semyon422/vsrgkb/README.md

# vsrgkb
 Split mechanical keyboard for rhythm games

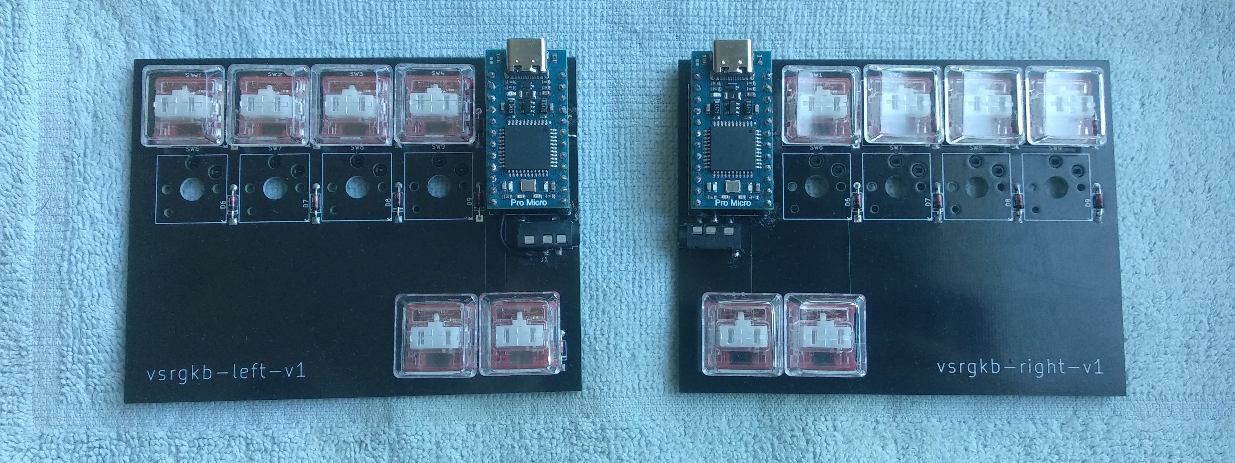
[picture p1: top.jpg]
top view

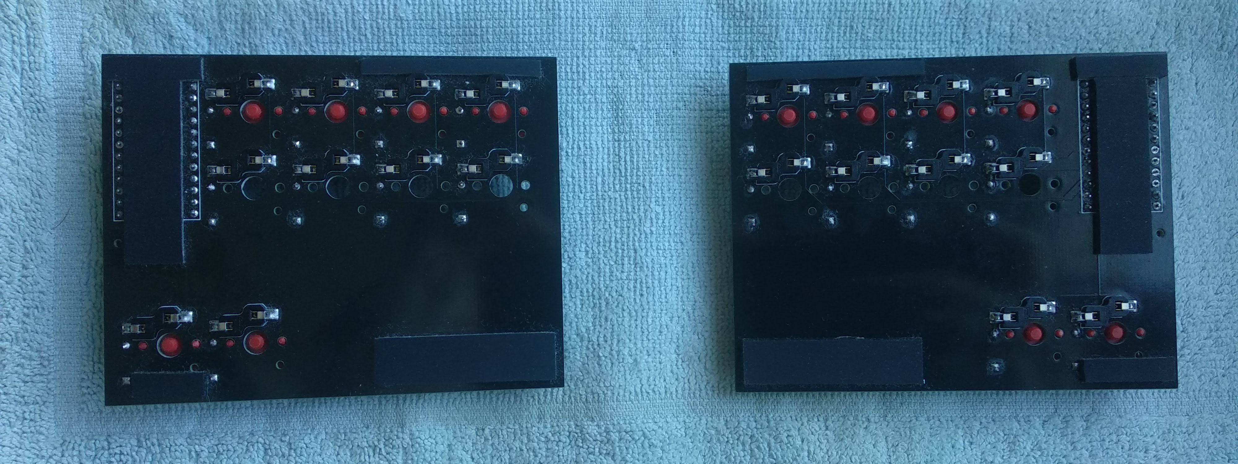
[picture p2: bottom.jpg]
bottom view
