semyon422/vsrgkb/kicad/readme.md

# hardware issues

## v1

Wrong pin choosen for communication. D1 is recommended.  
Pull-up and pull-down resistors are missing for handedness detection.
