semyon422/vsrgkb/kicad/vsrgkb-v1-left/vsrgkb-left.kicad_pcb

## KiCad design kicad/vsrgkb-v1-left/vsrgkb-left.kicad_pcb (2023-01-23)

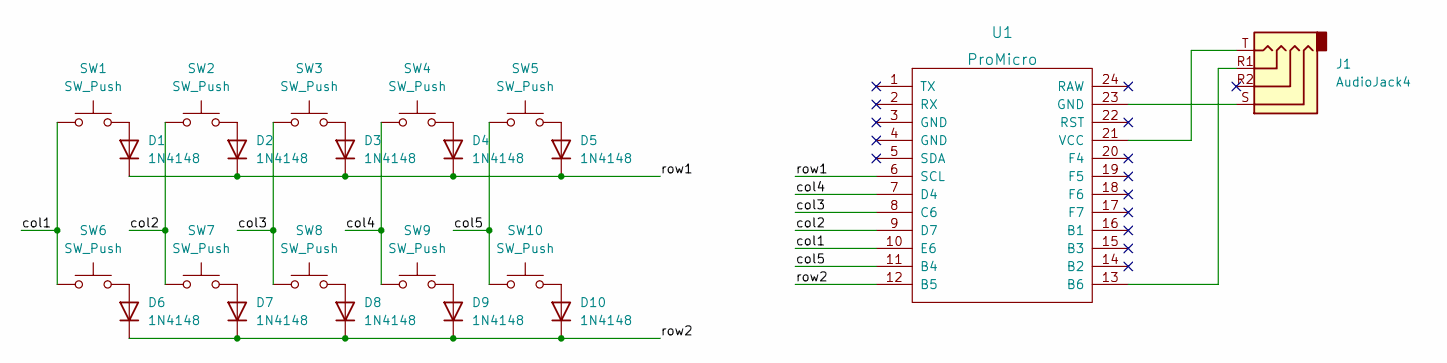
[picture p3: schematic vsrgkb-left.kicad_sch]

Parts:
D1, D2, D3, D4, D5, D6, D7, D8, D9, D10: 1N4148; D_DO-35_SOD27_P7.62mm_Horizontal
J1: AudioJack4; Jack_3.5mm_PJ320D_Horizontal
SW1, SW2, SW3, SW4, SW5, SW6, SW7, SW8, SW9, SW10: SW_Push; SW_Hotswap_Kailh_Choc_V1V2_1.00u
U1: ProMicro

Connections:
/col1: SW1.1, SW6.1, U1.10 (E6)
/col2: SW2.1, SW7.1, U1.9 (D7)
/col3: SW3.1, SW8.1, U1.8 (C6)
/col4: SW4.1, SW9.1, U1.7 (D4)
/col5: SW5.1, SW10.1, U1.11 (B4)
/row1: D1.1 (K), D2.1 (K), D3.1 (K), D4.1 (K), D5.1 (K), U1.6 (SCL)
/row2: D6.1 (K), D7.1 (K), D8.1 (K), D9.1 (K), D10.1 (K), U1.12 (B5)
unnamed: D2.2 (A), SW2.2
unnamed: D3.2 (A), SW3.2
unnamed: D6.2 (A), SW6.2
unnamed: D7.2 (A), SW7.2
unnamed: D8.2 (A), SW8.2
unnamed: D9.2 (A), SW9.2
unnamed: D10.2 (A), SW10.2
unnamed: J1.S, U1.23 (GND)
unnamed: D1.2 (A), SW1.2
unnamed: D4.2 (A), SW4.2
unnamed: D5.2 (A), SW5.2
unnamed: J1.R1, U1.13 (B6)
unnamed: J1.T, U1.21 (VCC)

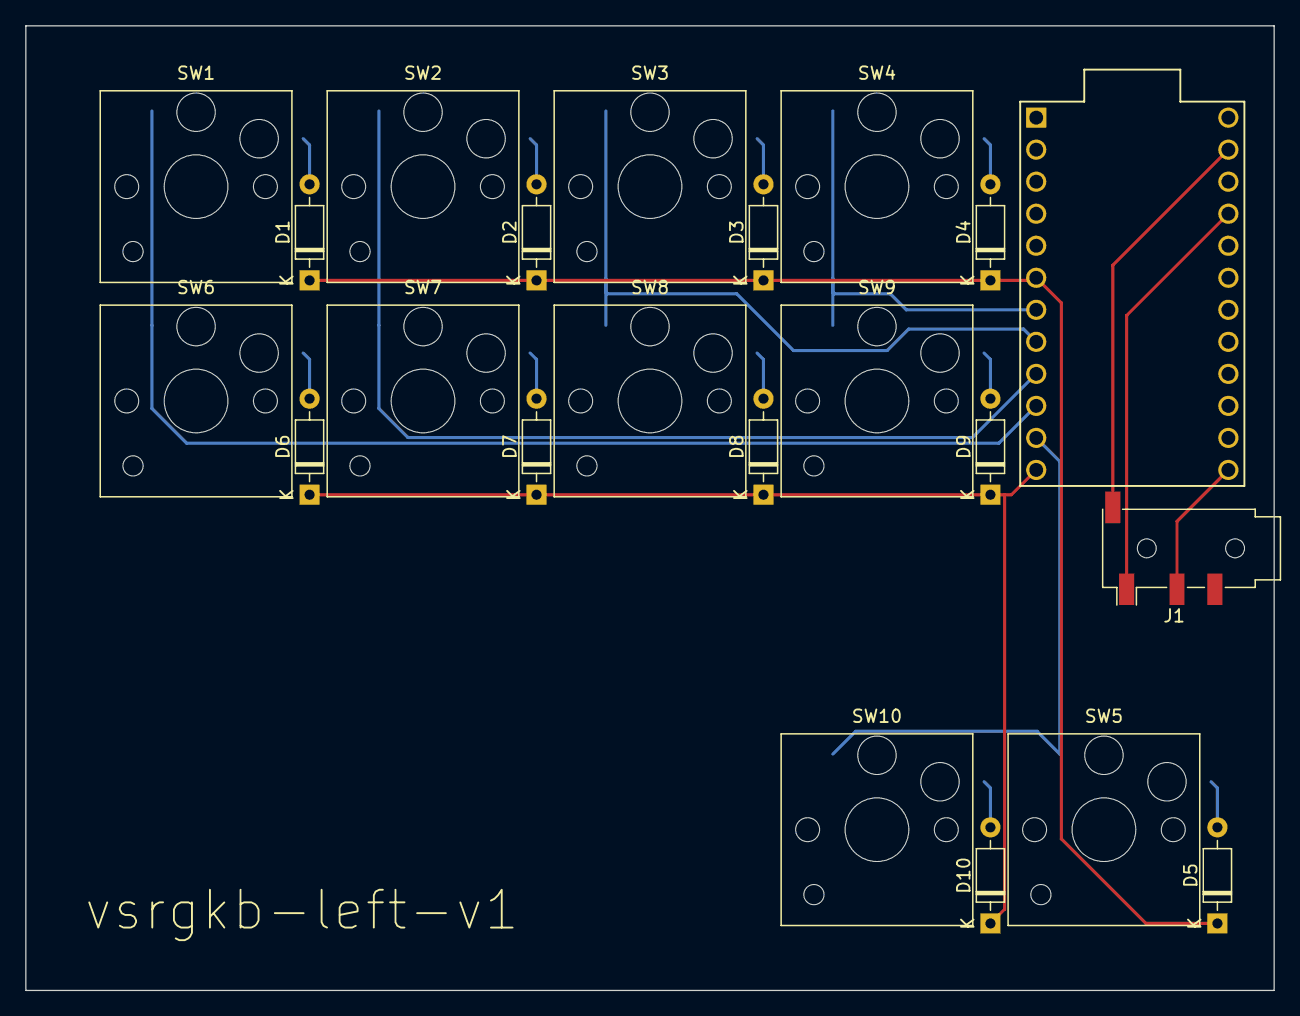
[picture p4: board vsrgkb-left.kicad_pcb from above]

Board: 2 copper layers, 99.0 x 76.5 mm, 22 parts (0 on the bottom side), 20 nets.
