semyon422/vsrgkb/kicad/vsrgkb-v1-left-modified/changes.png

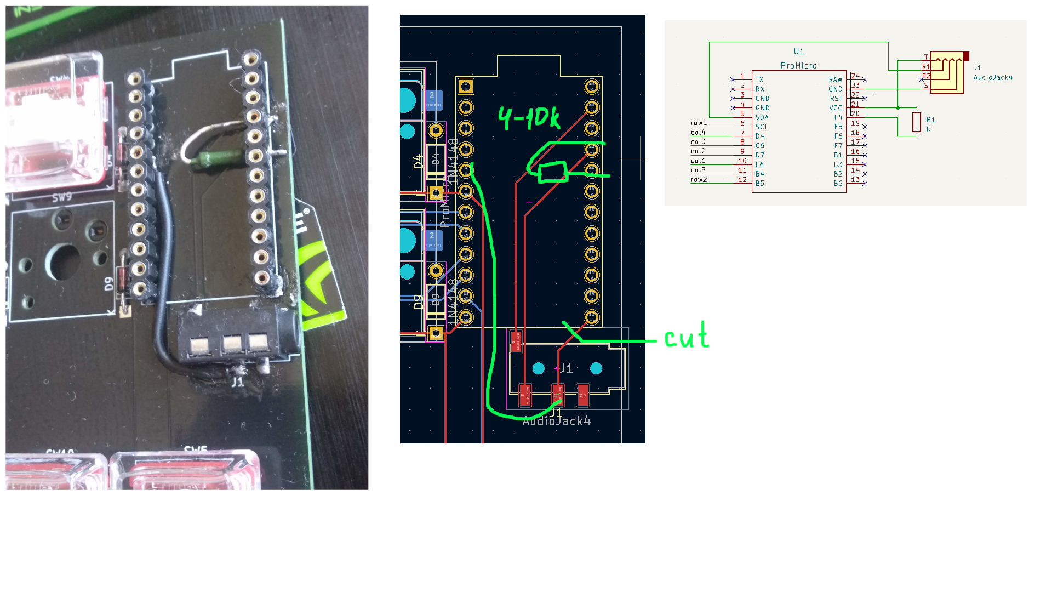
kicad/vsrgkb-v1-left-modified/changes.png
