semyon422/vsrgkb/kicad/vsrgkb-v1-right-modified/changes.png

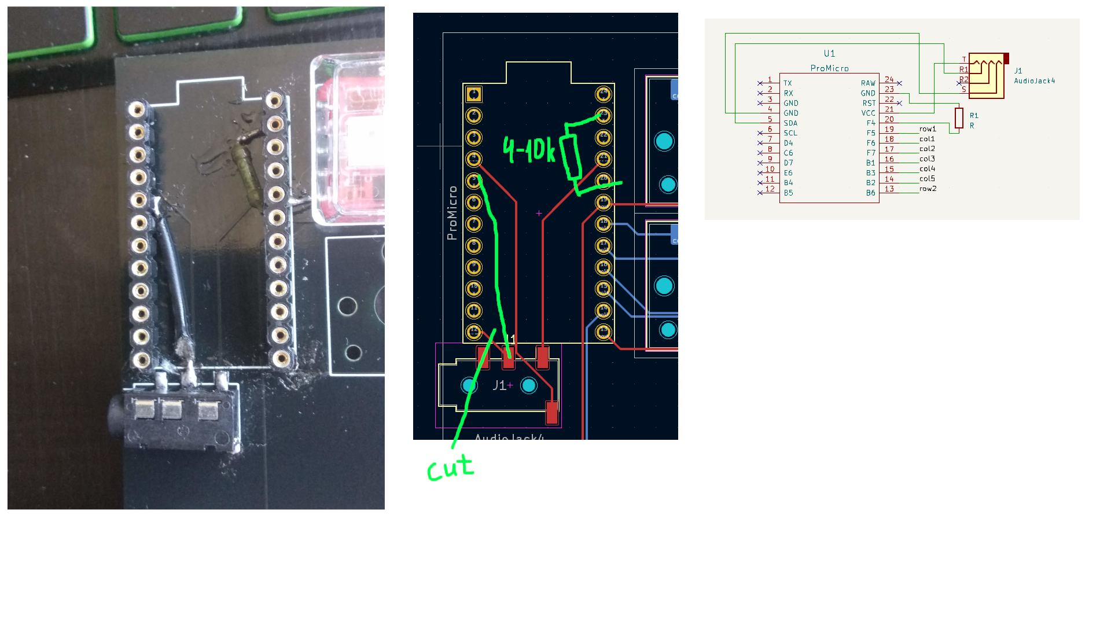
kicad/vsrgkb-v1-right-modified/changes.png
