semyon422/vsrgkb/(threads)

Thread 1 (2023-03-19):

Keyboard turns off

semyon422, 2023-03-19:
This is the first version of the keyboard, so some changes in the circuitry were required to get the necessary functionality. See `kicad/*-modified` folders to get all changes.

While playing, the keyboard can:
- reboot
- switch off
- turn off only one half

Sometimes the keyboard can come back to normal by itself, sometimes you need to reconnect it.

Sometimes the keyboard can work without failure for several days in a row, sometimes it can reboot at intervals of a few seconds.

These crashes were only noticed while playing.

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
